corneliusgruss/stack/hardware/docs/cable_routing_detail.png

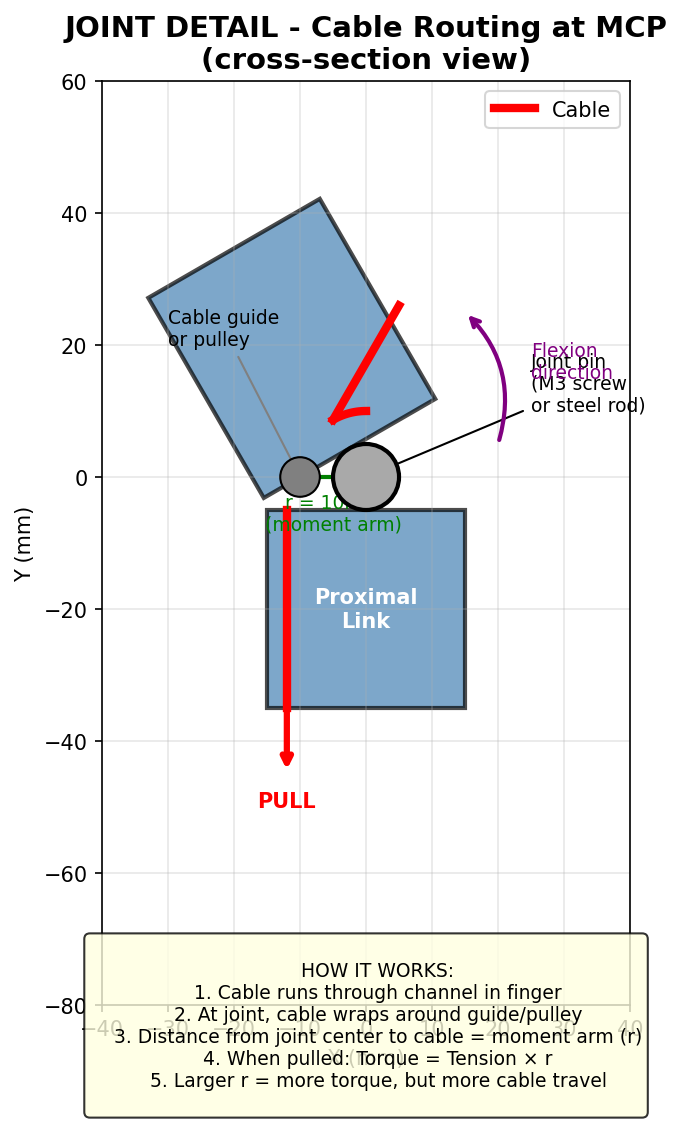
hardware/docs/cable_routing_detail.png
