corneliusgruss/stack/hardware/docs/finger_sketch_v2.png

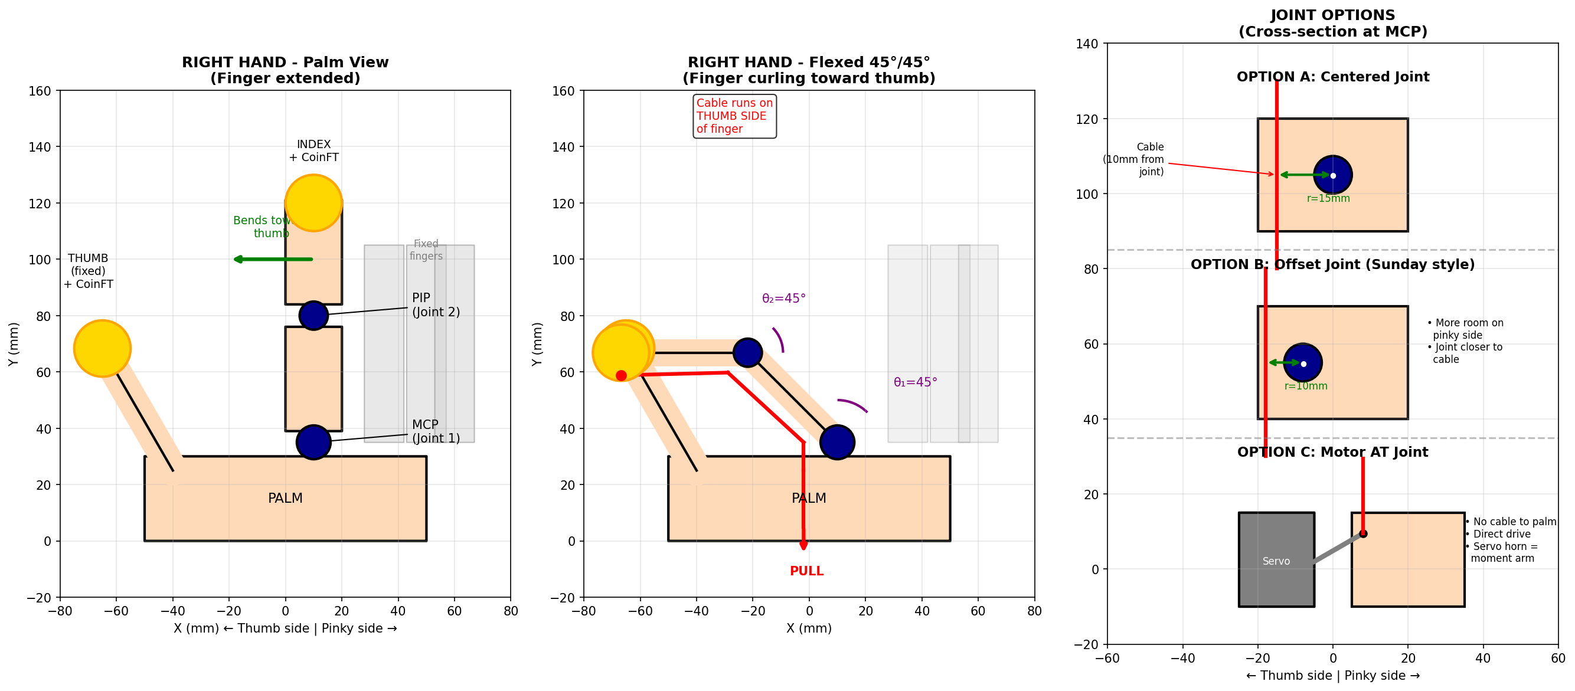
hardware/docs/finger_sketch_v2.png
