corneliusgruss/stack/hardware/docs/finger_workspace.png

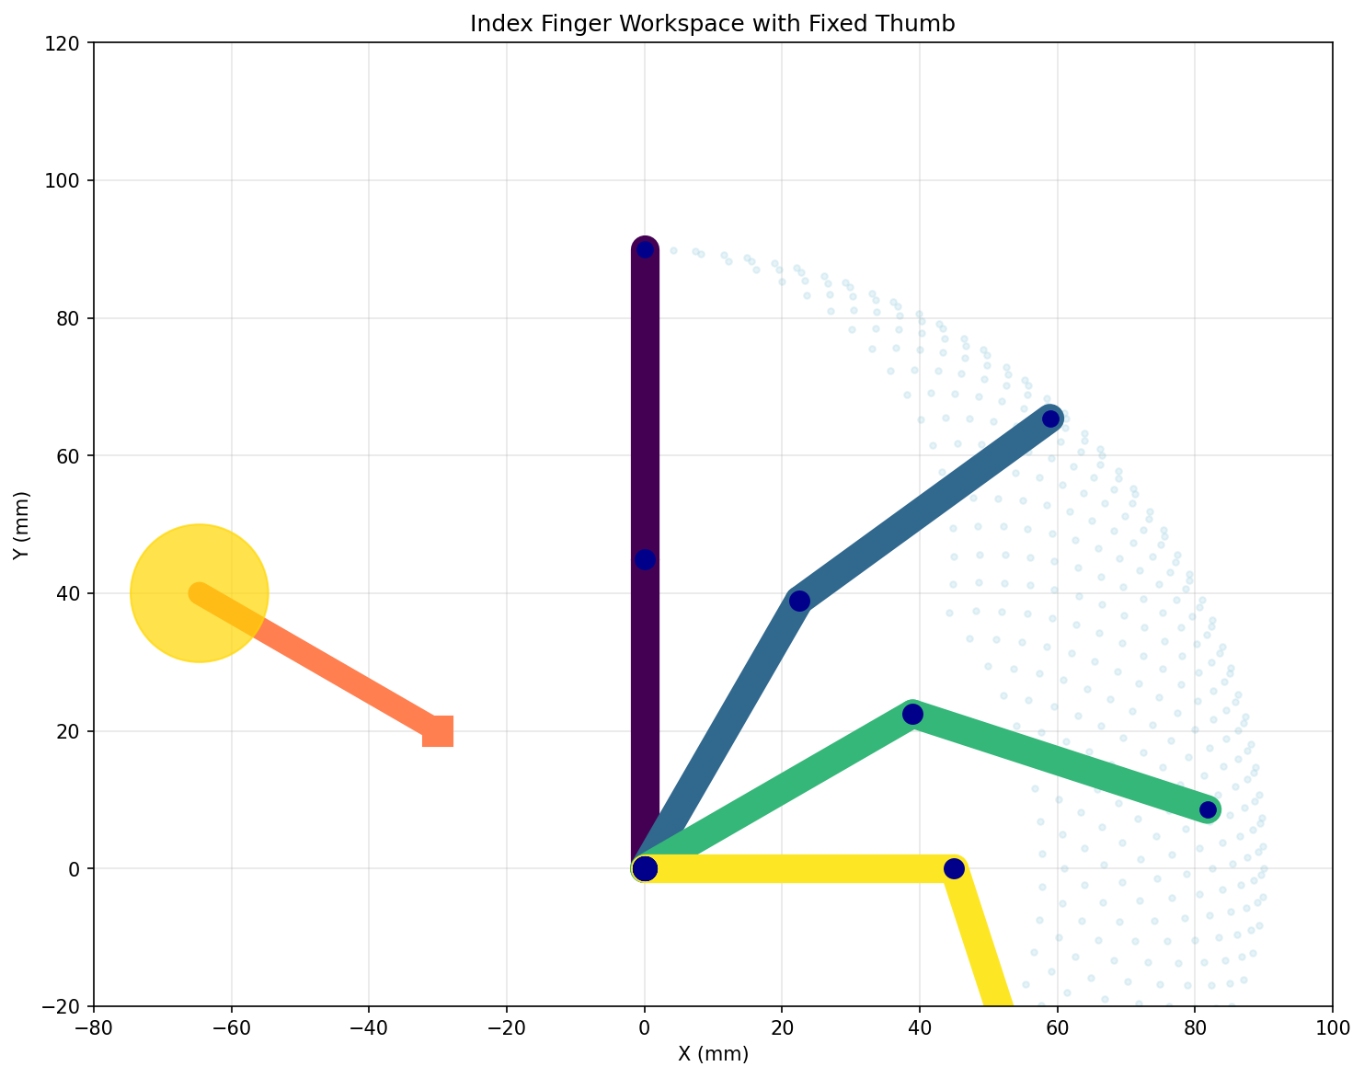
hardware/docs/finger_workspace.png
