corneliusgruss/stack/hardware/docs/fingertip_trajectory.png

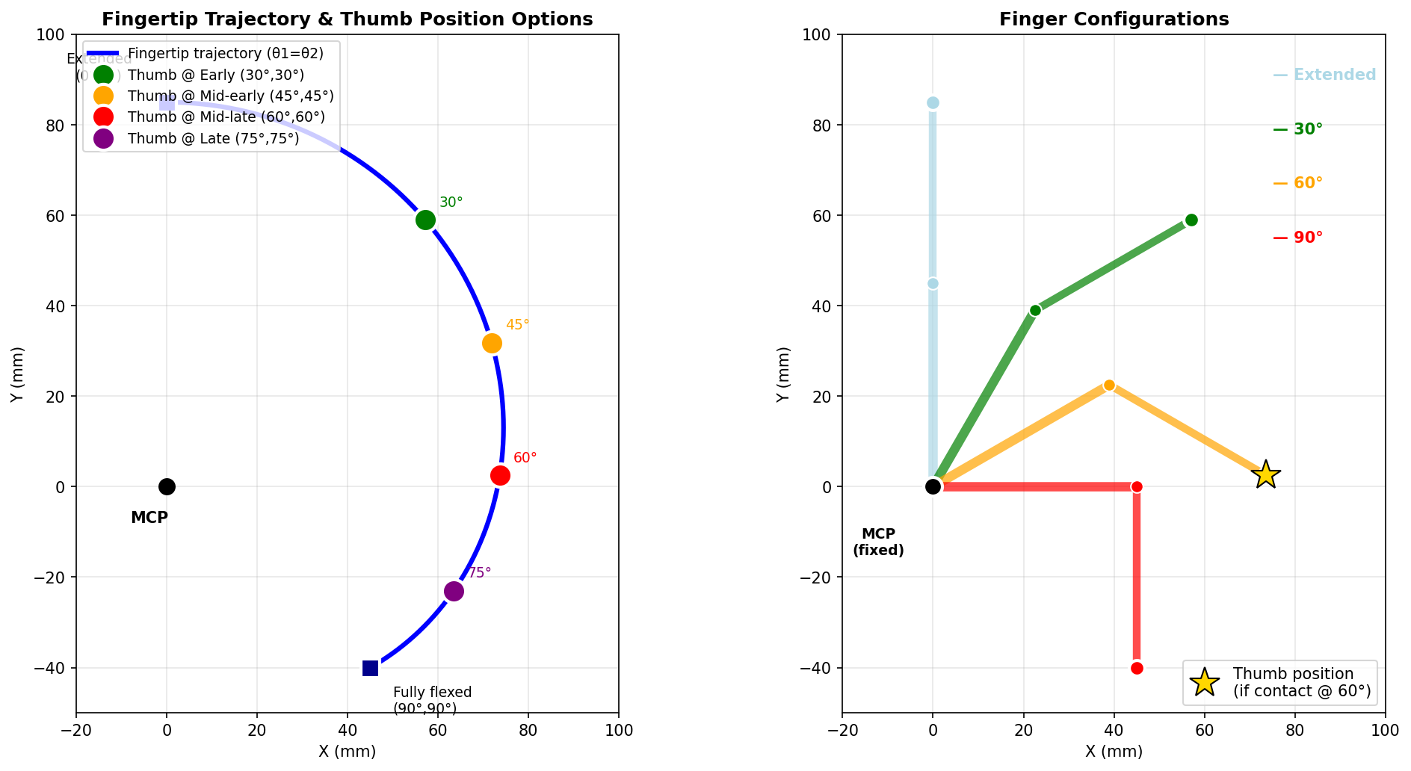
hardware/docs/fingertip_trajectory.png
