corneliusgruss/stack/hardware/docs/force_analysis.png

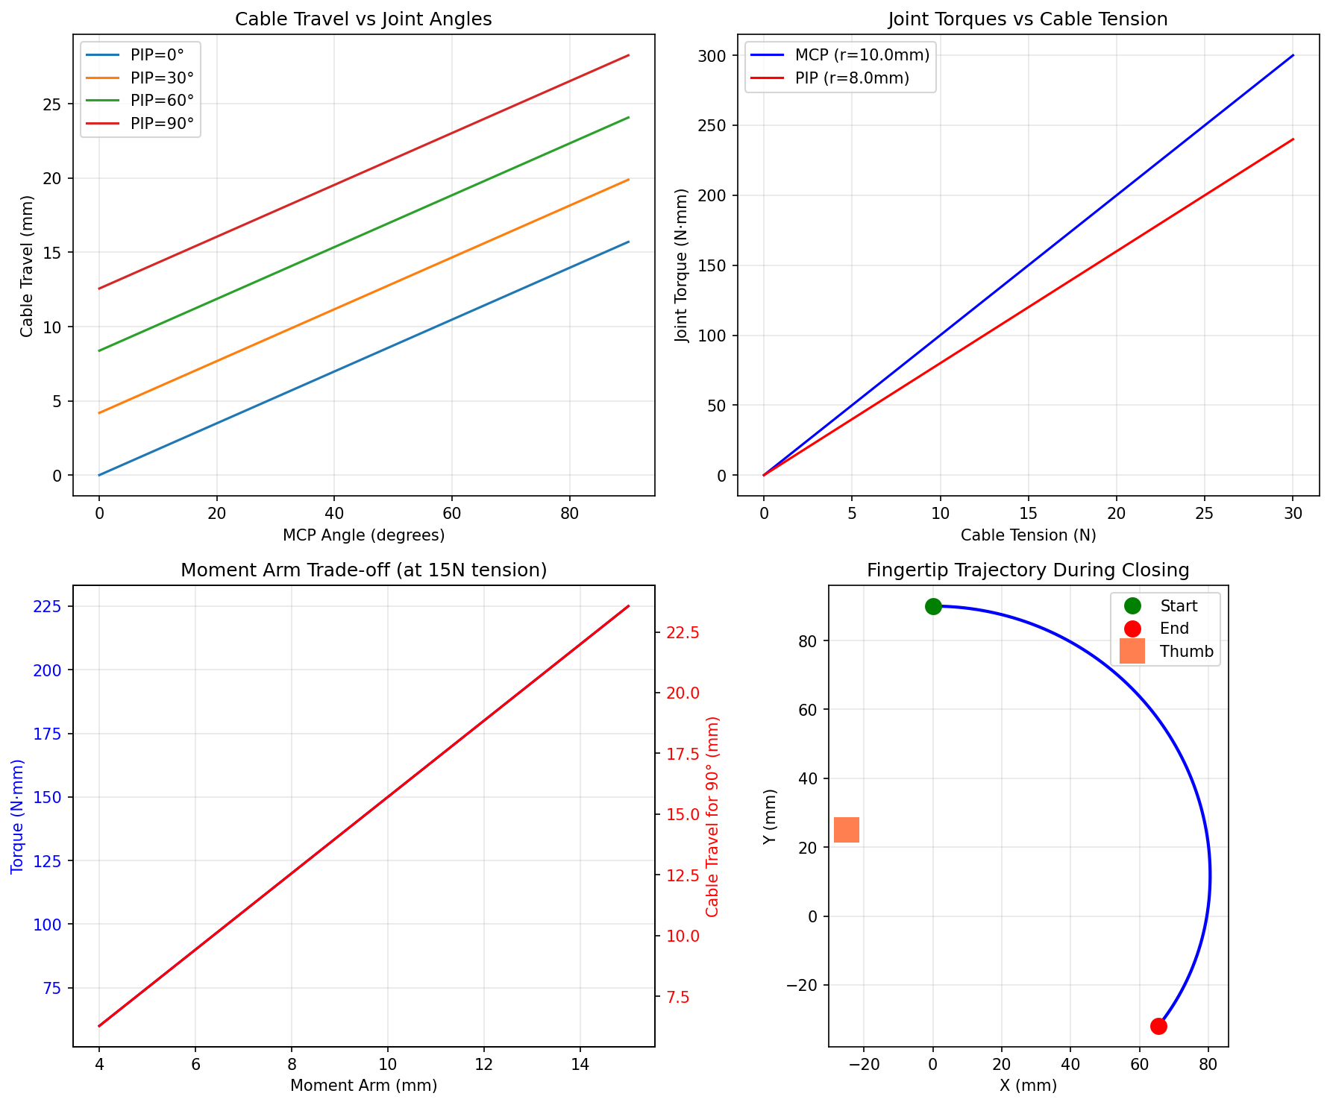
hardware/docs/force_analysis.png
