corneliusgruss/stack/hardware/cad/exports/3-finger-roll.3mf

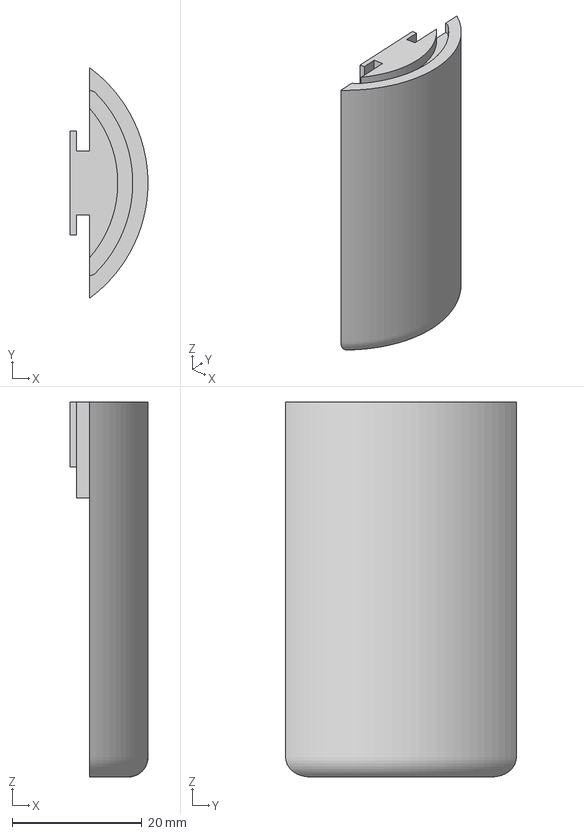
[picture p8: CAD file, 2026-02-17]
hardware/cad/exports/3-finger-roll.3mf
12.0 x 35.5 x 57.7 mm
