corneliusgruss/stack/hardware/cad/exports/glove_v2/Index-Distal.3mf

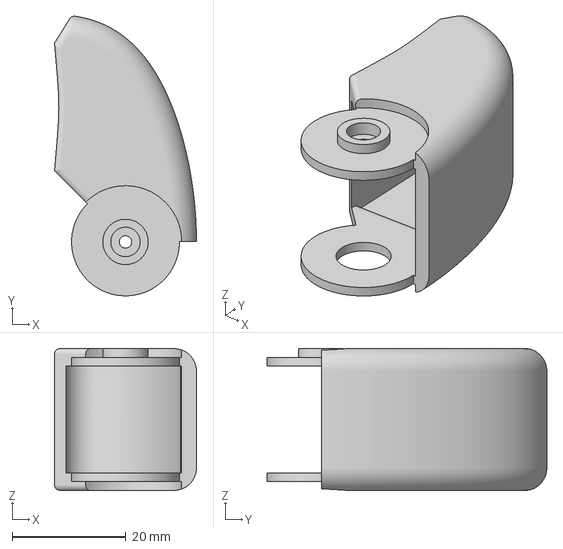
[picture p9: CAD file, 2026-02-20]
hardware/cad/exports/glove_v2/Index-Distal.3mf
25.0 x 49.2 x 25.0 mm
