corneliusgruss/stack/hardware/cad/exports/glove_v2/Palm.3mf

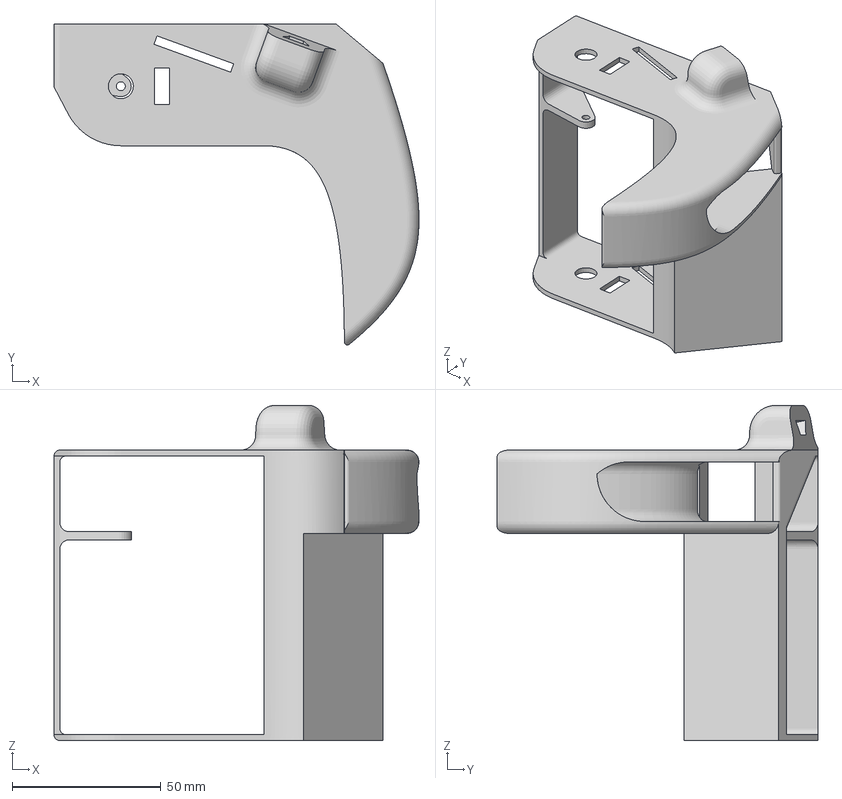
[picture p10: CAD file, 2026-02-17]
hardware/cad/exports/glove_v2/Palm.3mf
122.6 x 107.8 x 112.6 mm
