corneliusgruss/stack/hardware/cad/exports/index-proximal.3mf

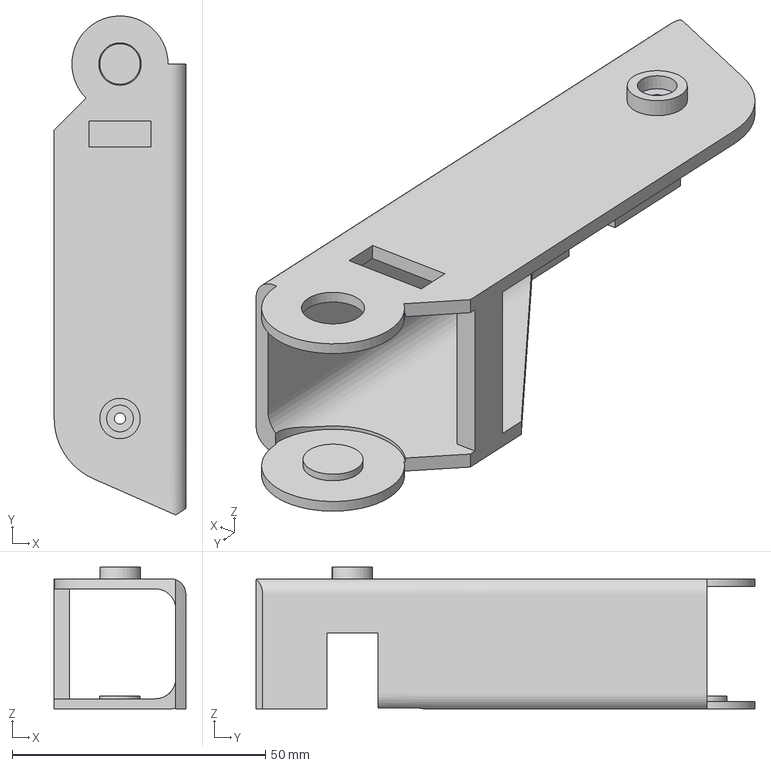
[picture p11: CAD file, 2026-02-17]
hardware/cad/exports/index-proximal.3mf
26.0 x 98.5 x 28.0 mm
