corneliusgruss/stack/hardware/cad/exports/glove_v2/IPhone-Mount.3mf

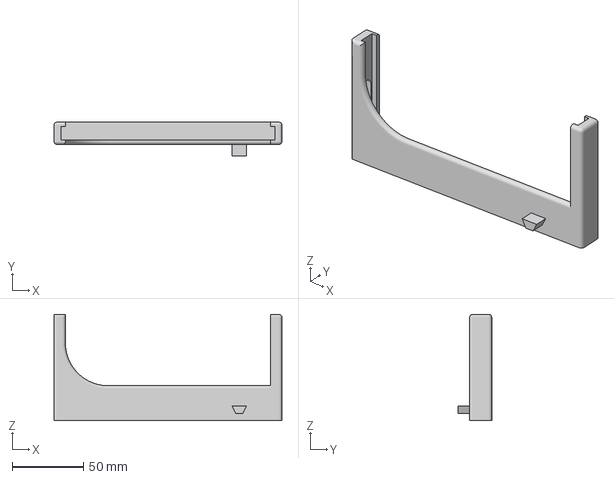
[picture p12: CAD file, 2026-02-17]
hardware/cad/exports/glove_v2/IPhone-Mount.3mf
159.7 x 23.5 x 74.5 mm
