corneliusgruss/stack/hardware/cad/exports/palm.3mf

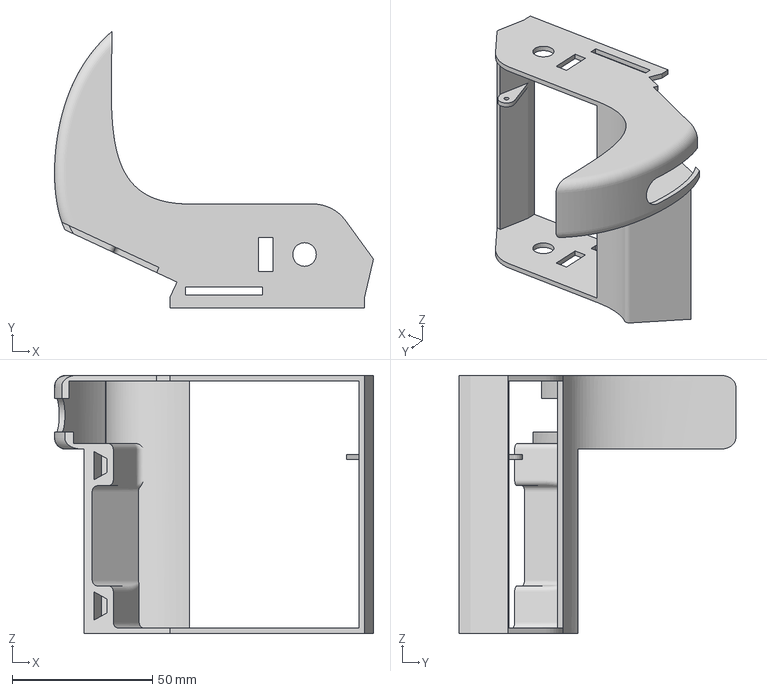
[picture p13: CAD file, 2026-02-17]
hardware/cad/exports/palm.3mf
113.6 x 98.6 x 92.0 mm
