corneliusgruss/stack/hardware/cad/exports/3-finger.3mf

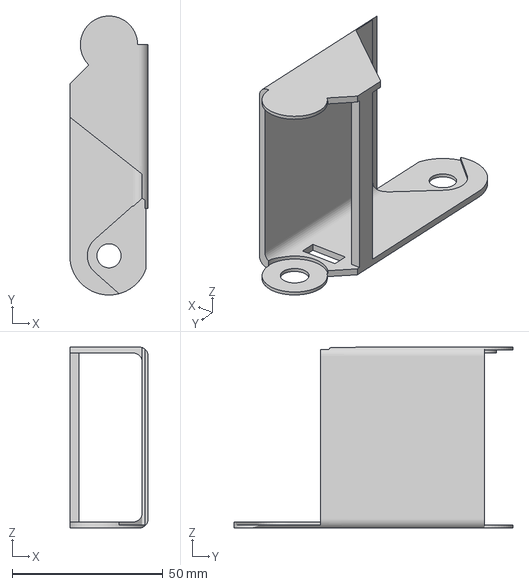
[picture p14: CAD file, 2026-02-17]
hardware/cad/exports/3-finger.3mf
26.0 x 92.5 x 60.0 mm
