corneliusgruss/stack/hardware/cad/exports/glove_v2/Index_Proximal.3mf

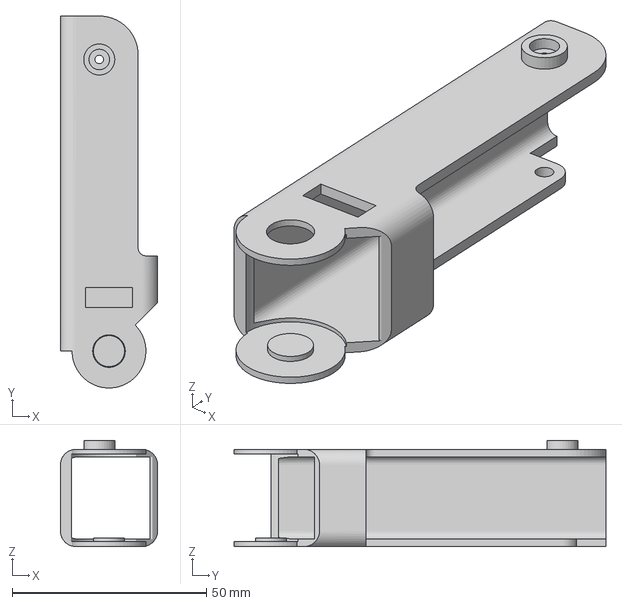
[picture p15: CAD file, 2026-02-17]
hardware/cad/exports/glove_v2/Index_Proximal.3mf
25.0 x 95.7 x 27.3 mm
