corneliusgruss/stack/hardware/cad/exports/3-finger-proximal.3mf

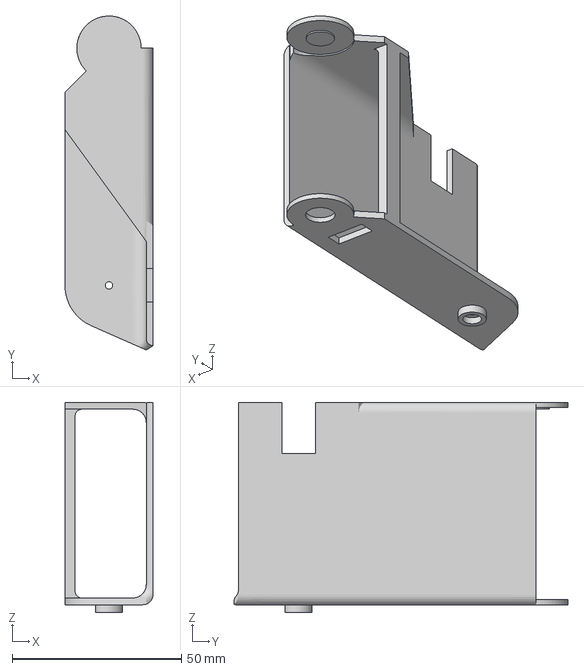
[picture p16: CAD file, 2026-02-17]
hardware/cad/exports/3-finger-proximal.3mf
26.0 x 98.5 x 62.0 mm
