corneliusgruss/stack/hardware/cad/exports/glove_v2/Encoder-Cap.3mf

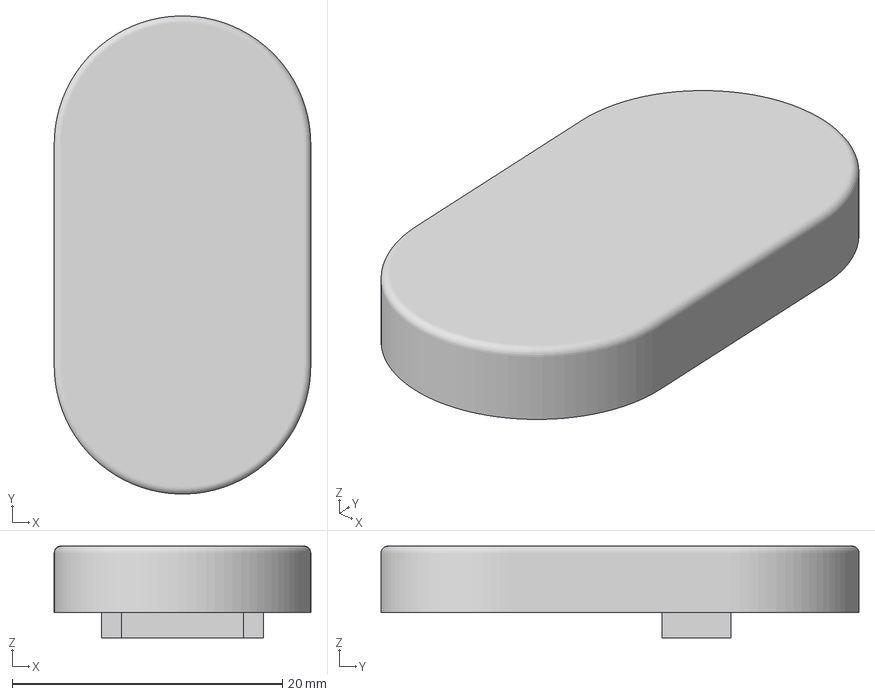
[picture p17: CAD file, 2026-02-17]
hardware/cad/exports/glove_v2/Encoder-Cap.3mf
19.0 x 35.4 x 6.80 mm
