corneliusgruss/stack/hardware/cad/exports/glove_v2/3Finger_Proximal.3mf

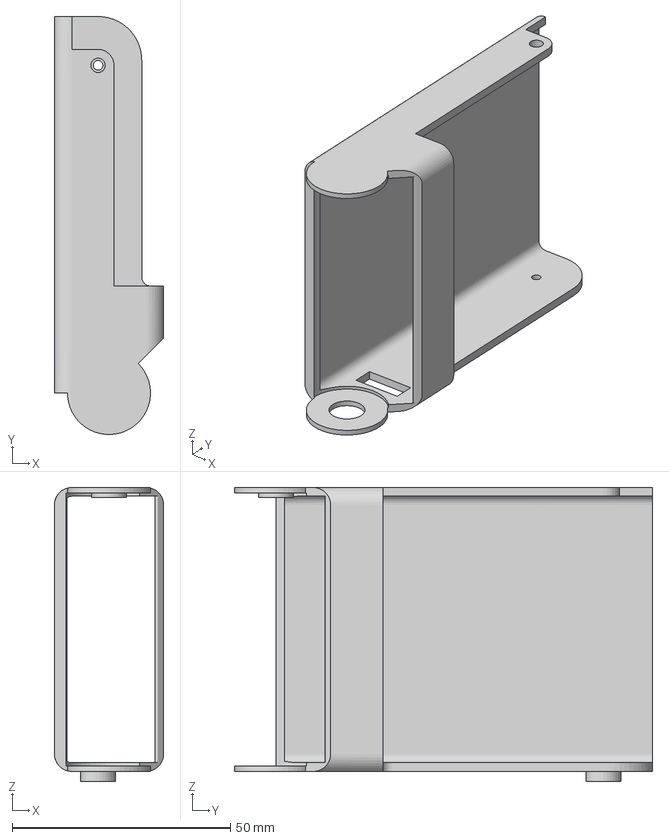
[picture p18: CAD file, 2026-02-17]
hardware/cad/exports/glove_v2/3Finger_Proximal.3mf
25.0 x 95.7 x 67.3 mm
