corneliusgruss/stack/hardware/cad/exports/index-distal.3mf

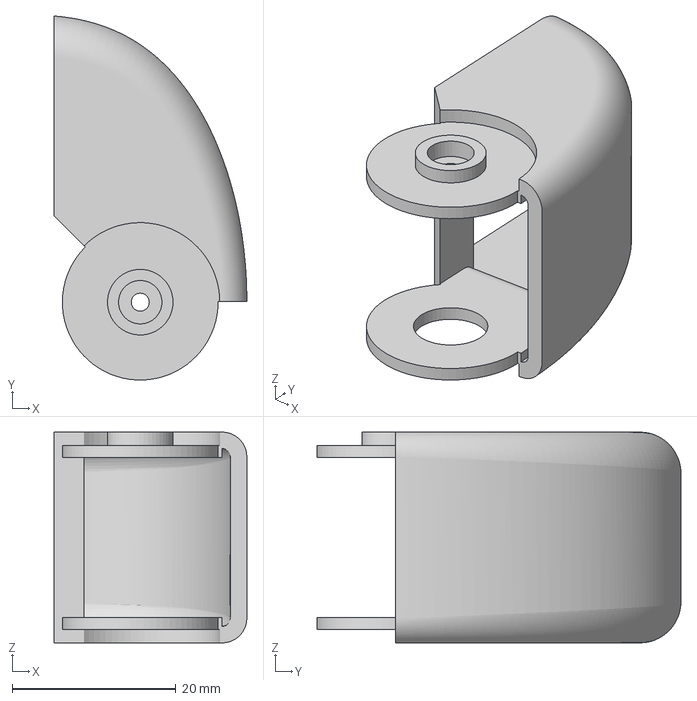
[picture p19: CAD file, 2026-02-17]
hardware/cad/exports/index-distal.3mf
23.5 x 44.4 x 25.7 mm
