corneliusgruss/stack/hardware/cad/exports/glove_v2/3Finger-Distal.3mf

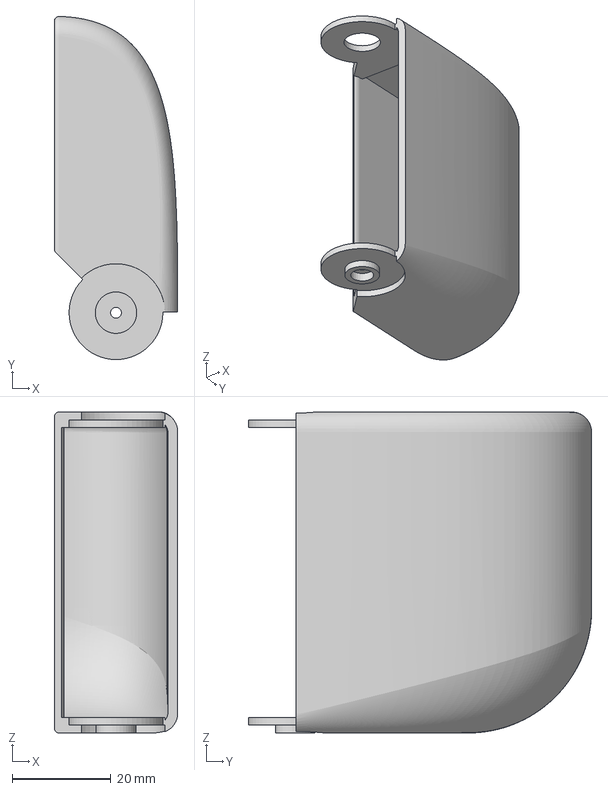
[picture p20: CAD file, 2026-02-17]
hardware/cad/exports/glove_v2/3Finger-Distal.3mf
25.0 x 69.5 x 65.0 mm
