corneliusgruss/stack/hardware/cad/exports/index-roll.3mf

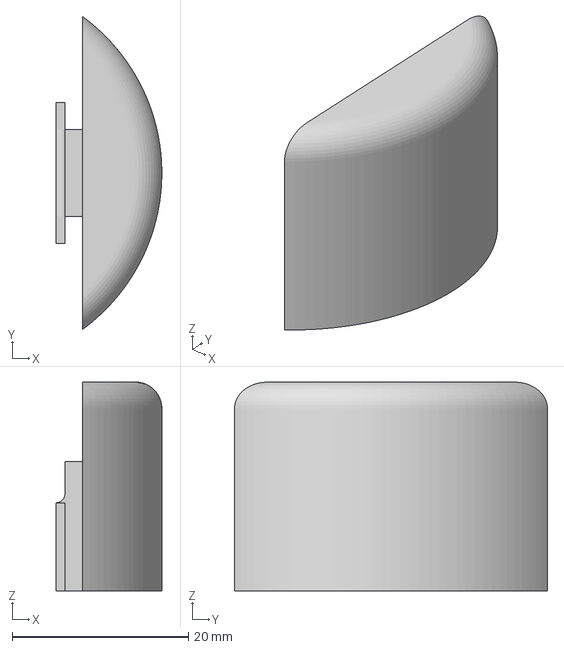
[picture p21: CAD file, 2026-02-17]
hardware/cad/exports/index-roll.3mf
12.0 x 35.5 x 23.7 mm
