corneliusgruss/stack/hardware/cad/exports/camera-mount.3mf

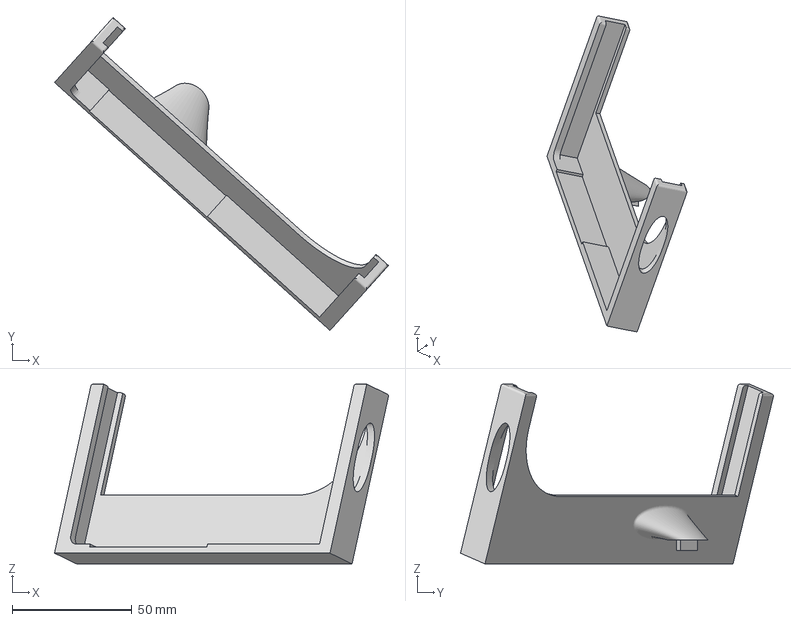
[picture p22: CAD file, 2026-02-17]
hardware/cad/exports/camera-mount.3mf
139.6 x 130.9 x 75.2 mm
