corneliusgruss/stack/hardware/cad/exports/glove_v2/MCP_Pin.3mf

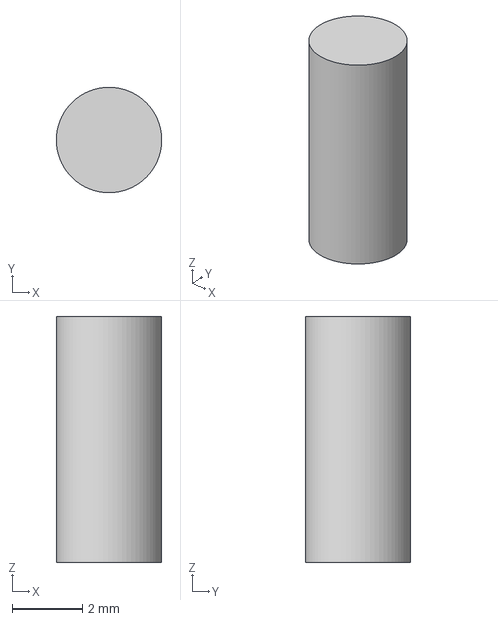
[picture p23: CAD file, 2026-02-17]
hardware/cad/exports/glove_v2/MCP_Pin.3mf
3.00 x 3.00 x 7.00 mm
