corneliusgruss/stack/hardware/cad/exports/encoder-cap.3mf

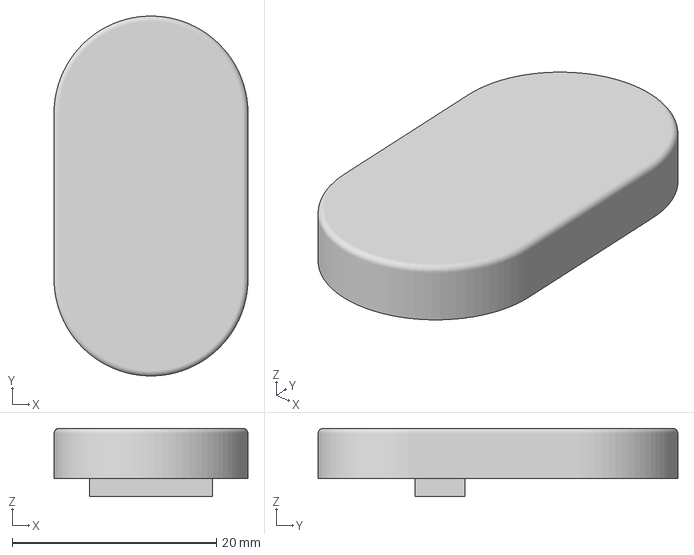
[picture p24: CAD file, 2026-02-17]
hardware/cad/exports/encoder-cap.3mf
19.0 x 35.2 x 6.70 mm
