corneliusgruss/stack/(list of files, cad)

Other CAD files:
hardware/cad/exports/glove_v2/Body1.3mf
hardware/cad/archive/3-proximal.3mf
hardware/cad/archive/camera-mount.3mf
hardware/cad/archive/finger-connector.3mf
hardware/cad/archive/index-finger-1.3mf
hardware/cad/archive/index-index.3mf
hardware/cad/archive/index-mcp-rol.3mf
hardware/cad/archive/index-pip-pins.3mf
hardware/cad/archive/index-proximal.3mf
hardware/cad/archive/mcp_joint_test_v1.3mf
hardware/cad/archive/palm.3mf
hardware/cad/archive/test-3.3mf
hardware/cad/archive/test-infex.3mf
hardware/cad/archive/test-palm.3mf
hardware/cad/archive/test-pip-joint-1.3mf
hardware/cad/archive/test-pip-joint-2.3mf
hardware/cad/archive/test-roll-1.3mf
hardware/cad/archive/test-roll-2.3mf
hardware/cad/archive/test-tab-slot-2.3mf
hardware/cad/archive/test-tab-slot.3mf
hardware/cad/archive/test-tab.3mf
