corneliusgruss/stack/(commit log)

2026-01-27 Initial project setup
    ME740 Spring 2026 - Bimanual imitation learning for cube stacking
2026-01-27 Major gripper redesign: 4 encoders, moving 3-finger unit
    - Added AS5600 magnetic encoders to all 4 joints (MCP + PIP for both units)
    - 3-finger unit (middle/ring/pinky) now moves with same mechanism as index
    - Robot deployment now optional - can validate via held-out demos or sim
    - Added electronics section (ESP32 + I2C multiplexer)
    - Updated BOM: ~$133 total
    - Inspired by Sunday Robotics Skill Capture Glove
    [design_validation.py, finger_analysis.py, finger_sketch.py, finger_sketch_v2.py]
2026-02-01 Add iOS ARKit capture app (StackCapture)
    SwiftUI app for iPhone 15 Pro that captures synchronized:
    - 6DoF pose from ARKit world tracking (60 Hz)
    - RGB frames as JPEG (1920x1440, 60 Hz)
    - LiDAR depth as Float32 binary (256x192, 30 Hz)
    Key implementation details:
    - Immediate JPEG encoding to avoid ARKit buffer recycling
    - Async batch storage with pose sorting on finalize
    - USB file transfer via Finder (UIFileSharingEnabled)
    - Session browser with metadata and export to ZIP
    Python loader (stack/data/iphone_loader.py) for loading sessions
    with automatic pose sorting and Float32 depth support.
    Tested: 60 FPS capture with 0% frame drops.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
    [iphone_loader.py]
2026-02-01 Add visualization tools and update CLAUDE.md
    - stack/viz/iphone_viz.py: Frame browser, 3D trajectory plot,
    depth colorization, pose overlay, session statistics
    - CLI: python -m stack.scripts.visualize_iphone <session_path>
    - Updated CLAUDE.md with today's progress:
    - iOS capture verified at 60 FPS
    - Orientation confirmed for horizontal mount
    - Current blockers documented
2026-02-17 Add training pipeline, BLE integration, firmware, and CAD exports
    Complete system from hardware to policy training:
    - ESP32 firmware with Serial + BLE dual output (encoder_reader, board_test)
    - iOS StackCapture: BLE manager, ultrawide camera, landscape mode, HEVC video, LiDAR depth
    - Diffusion policy (ResNet18 + ConditionalUnet1D, matches Chi et al.)
    - Training pipeline: synthetic data, dataset, train loop, eval, 16 passing tests
    - Hardware: analysis scripts, gripper physics package, CAD exports (3mf), build log
    - Reorganized hardware/ (analysis scripts → analysis/, diagrams → docs/)
    - Added .gitignore, requirements.txt, configs, Colab notebook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
    [3-finger-proximal.3mf, 3-finger-roll.3mf, 3-finger.3mf, 3-proximal.3mf, 3Finger-Distal.3mf, 3Finger_Proximal.3mf, Body1.3mf, Encoder-Cap.3mf]
2026-02-18 Camera-agnostic capture pipeline: ultrawide-only iOS + DROID-SLAM
    Remove ARKit dependency entirely. StackCapture now uses AVFoundation
    with the ultrawide camera (120° FOV) + CoreMotion IMU. Poses are
    filled offline via DROID-SLAM instead of relying on Apple APIs.
    - iOS: RawCaptureSession (ultrawide + IMU), simplified CaptureCoordinator
    - Firmware: per-channel encoder direction invert
    - Python: SessionLoader (renamed from iPhoneSession, backward compat)
    - DROID-SLAM: Colab notebook + CLI script for offline pose estimation
    - Loader: IMU/intrinsics/captureSource support, SLAM validation
    [encoder_reader.ino, iphone_loader.py]
2026-02-18 Switch notebook from DROID-SLAM to COLMAP (pip-installable)
    DROID-SLAM requires building lietorch/pytorch_scatter from source which
    times out on Colab. COLMAP via pycolmap is pip-installable and reliable.
    Pipeline: subsample 60fps→10fps, COLMAP SfM, interpolate poses back.
    Includes batch processing function for all 17 sessions.
2026-02-18 Local COLMAP processing: 17/17 sessions done on MacBook
    Rewrote run_slam.py from DROID-SLAM to COLMAP SfM. Runs locally
    with brew-installed colmap — no GPU, no Colab needed for poses.
    Pipeline: subsample 60→10fps, SIFT extraction, sequential matching,
    incremental SfM, Slerp interpolation back to 60fps.
    All 17 sessions processed successfully (793–2970 poses each).
    Updated CLAUDE.md with current status and pipeline docs.
2026-02-18 Update training notebook for Drive-based workflow
    Mount Drive, symlink sessions into data/raw/, train with real data.
    Saves checkpoint back to Drive for persistence across sessions.
2026-02-18 Make encoder/dataset imports optional in data __init__
    pyserial not available on Colab, not needed for training.
2026-02-19 Remove dead depth dimension (12D→11D) and add IMU-based scale calibration
    Depth observation (index 11) was always zero since ultrawide camera has no
    LiDAR. Removed it throughout the pipeline: obs_dim 12→11, get_episode_11d(),
    deprecated get_episode_12d() alias. Also added per-session scale calibration
    using IMU velocity-change matching against COLMAP positions, auto-runs after
    COLMAP processing, and eval now reports correct units (m vs COLMAP units).
    Also includes eval visualization module (eval_viz) with trajectory comparison
    plots, error distributions, video overlays, and composite dashboard.
    [iphone_loader.py, synthetic.py]
2026-02-19 Reduce hidden_dim 256→64 to match dataset size (35 sessions)
    100M trainable params on 44K samples was massive overfitting risk.
    hidden_dim=64 gives 6.4M trainable params (144 params/sample).
2026-02-20 Add pack_for_scc.py and use packed data on SCC
    Resizes images 480x360→224x224 before upload, 72% disk savings
    (2.6GB→717MB). Training points to data/packed/ instead of data/raw/.
2026-02-20 Add wandb integration to train, eval, and eval_viz scripts
    - train.py: log sample prediction images, hardware info, model artifacts
    - eval.py: log per-session metrics table and aggregate scalars to wandb
    - eval_viz.py: upload dashboard, trajectory, and error distribution images
    - pyproject.toml: add wandb optional dependency
    [Index-Distal.3mf]
2026-02-20 Fix encoder 0°/360° boundary discontinuity in loader and firmware
    Imperfect magnet mounting causes zero-crossings that create large
    discontinuities in joint angle data, breaking normalization and
    confusing the diffusion policy during training.
    - Loader: unwrap encoder channels with np.unwrap(period=360) to make
    existing session data continuous
    - Firmware: change wrapping from [0,360) to signed [-180,180) centered
    on calibration point
    [encoder_reader.ino, iphone_loader.py]
2026-02-20 Add 7D ablation config (pose only, no joints)
    Dataset now accepts action_dim parameter to slice episodes.
    7D ablation uses same architecture/hyperparams as 11D for fair comparison.
2026-02-21 Switch action repr: absolute 11D quat → relative 13D 6D rotation
    Replace absolute quaternion actions with relative 6D rotation representation
    (Zhou et al., CVPR 2019) for continuity and frame-invariance. New 13D format:
    [dx, dy, dz, r1..r6, j1..j4] relative to last observation timestep.
    - Add stack/data/transforms.py with SE(3) math utilities
    - Add get_all_transforms() to SessionLoader
    - Add action_repr field to PolicyConfig (backward compat: old ckpts → absolute_quat)
    - Update dataset to compute relative transforms on the fly in __getitem__
    - Update train/eval/eval_viz/sim scripts to branch on action_repr
    - 31 tests passing (was 16), including transform round-trips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
    [iphone_loader.py]
